gridjak1612/TDC-work_BTP/data/MANIFEST.md

# Capture manifest

Build parameters below were INFERRED from the data (code range, dead-zone
location), not recorded at capture time. From now on, record them when capturing.

| File | Build (inferred) | Codes (A) | Dead zone | Notes |
|---|---|---|---|---|
| sweep_full.csv | SYNC_TAP=0, TAP_SRC=0 | 1..288 | ph 268..275 (A), 268..275 (B) | Source of the 10.1 ps result and slide-2 even/odd. 185 seq gaps |
| probe.csv, probe2.csv | SYNC_TAP=0, TAP_SRC=0 | 1..288 | same as sweep_full | probe.csv -> lut_a/lut_b |
| sweep_v2.csv | SYNC_TAP=30, TAP_SRC=0 | 84..351 | ph 189..213 (A), 182..214 (B) | 474 seq gaps; 1 corrupt frame (phase = -859) |
| probe_ilv.csv, ilv_check.csv | SYNC_TAP=30, TAP_SRC=0 on both chains (NOT interleaved) | 84..351 | as sweep_v2 | Identical to sweep_v2 at 279/280 phases. Source of slide 4/7 DNL/INL |
| probe3.csv, live.csv | SYNC_TAP=30 | 84..351 | - | live.csv has host-computed interval_ps |
| tdc_dual_log.csv, tdc_log.csv | pre-DPS builds | - | - | historical |
| lut_full_*.csv | from sweep_full | | | |
| lut_v2_*.csv | from sweep_v2 | | | |

## Rule from here on
Name every capture `<date>_<githash>_<desc>.csv`, e.g. `0925_a1b2c3d_sweep_sync30.csv`,
and add one line here: build params, bitstream hash, temperature if known.
A LUT is only valid for the bitstream (placement) it was built from.
| 0924b_f62460d_ro7_sync30.csv | EVENT_SRC=3, RO_STAGES=7, f62460d, 5-min warm-up | 2.97 M frames |
| 0924b_f62460d_dps_sync30.csv | EVENT_SRC=2 (DPS), f62460d, 5-min warm-up | 1.36 M frames, LED7 off throughout |
| 0924b_f62460d_ro11_sync30.csv | EVENT_SRC=3, RO_STAGES=11, f62460d, 5-min warm-up | 3.02 M frames |
| 0924c_e0f33e7_ro7_sync30_ds.csv | step 4 DUAL_SNAP=1, e0f33e7 | 3.17 M frames. Chain A dead zone 0. Chain B biased by the pairing bug (2.65 % timeouts): do NOT use lut_cd7_ds_b |
| 0924d_0dcbbe8_ro7_sync30_ds.csv | DUAL_SNAP=1 + either-order pairing, 0dcbbe8, 5-min warm-up | 3.26 M frames; dead zone 0 both chains; 0 timeouts; sigma_pair 14.65 ps. LUT: lut_cd7_final (valid for 0dcbbe8 only) |
| 0924e_0dcbbe8_ro7_sync30_ds.csv | 0dcbbe8, independent eval run for calib_report | 2.16 M frames; residual DNL rms 0.02 LSB, residual INL <= 7 ps, sigma 10.34 ps/ch |
| 0925_multi_ro7.csv + 0925_multi_dps.csv | multi-source bitstream (EVENT_SRC=4), SW2 only (SW1 faulty) | RO7 2.99M, DPS 1.40M, dead zone 0 in both. Same-bitstream CD vs DPS: scale 0.5 %, shape +/-25 ps, CD LUT on DPS data 14.2-14.9 ps vs 11.2-12.1 ps |
| 0925_m3_ro7.csv + 0925_m3_ro11.csv | multi-source build, source select on SW2+SW3 (T2) | RO7 vs RO11 same bitstream: corr 1.000, 0.30 ps/bin, 0.00 % scale, +/-4 ps shape -> RO hit uniformity validated |
