gridjak1612/TDC-work_BTP/code/ilv_report.txt

loaded 1433607 rows from probe_ilv.csv
sequence gaps (dropped measurements): 0
up-traversal rows: 719367   down-traversal rows: 714240
phase step 17.857 ps, 280 steps, period 5000.0 ps

==========================================================================
  CHAIN A
==========================================================================
  usable samples : 1306594
  railing phases : 24 steps = 429 ps dead zone
      phases 189..212  (429 ps)
      This is the launch-skew ambiguity: events landing inside the
      capture synchroniser's setup window resolve either way, so the
      snapshot is taken one clock late and the chain reads full.

  --- transfer curve (mean code vs phase) ---
      phases with data : 256 / 280
      code range       : 84.0 .. 351.0
      median slope     : -0.990 codes / step   -> tau = 18.03 ps/tap
      steps against the dominant direction : 0 / 254  (0.0 %)

  --- code density (aggregate histogram) ---
      reachable codes  : 84 .. 351  (268 codes)
      headroom unused  : 1 taps above the reachable range
      zero-width bins  : 16 / 268 (6.0 % WITHIN the reachable range)
      phase coverage : 256/280 steps = 4571 ps
      LSB (covered/268) : 17.06 ps
      widest bin     : 77.2 ps (code 344)
      narrowest bin  : 0.00 ps (code 169)
      NOTE bin widths here are jitter-broadened; use the transfer
      curve for the transfer function and these for DNL shape only.
      DNL : -1.00 / +3.53 LSB
      INL : -3.94 / +7.79 LSB (-67 / +133 ps)
      widest bins (code: ps, xLSB):
         344:77(4.5x)  180:77(4.5x)  196:59(3.5x)  112:57(3.3x)  248:55(3.2x)  132:54(3.1x)  84:54(3.1x)  172:54(3.1x)  92:52(3.0x)  120:52(3.0x)
      even bins :  29.29 ps (n=134)   odd bins :   4.82 ps (n=134)
      EVEN/ODD ratio : 6.08x    85.9 % of the period is in even bins
         code %% 4 == 0 :  29.77 ps
         code %% 4 == 1 :   5.14 ps
         code %% 4 == 2 :  28.82 ps
         code %% 4 == 3 :   4.50 ps
      RMS quantisation, actual bins  : 10.43 ps
      RMS quantisation, if uniform   : 5.24 ps   <- headroom from tap interleaving
      clock-region boundary bins (predicted at taps (80, 280)):

  --- up vs down traversal (MMCM DPS hysteresis) ---
      phases compared : 254
      mean(up - down) : -0.002 codes = +0.0 ps
      worst |up-down| : 0.09 codes

==========================================================================
  CHAIN B
==========================================================================
  usable samples : 1261507
  railing phases : 33 steps = 589 ps dead zone
      phases 182..214  (589 ps)
      This is the launch-skew ambiguity: events landing inside the
      capture synchroniser's setup window resolve either way, so the
      snapshot is taken one clock late and the chain reads full.

  --- transfer curve (mean code vs phase) ---
      phases with data : 249 / 280
      code range       : 90.0 .. 351.0
      median slope     : -0.996 codes / step   -> tau = 17.94 ps/tap
      steps against the dominant direction : 0 / 247  (0.0 %)

  --- code density (aggregate histogram) ---
      reachable codes  : 90 .. 351  (262 codes)
      headroom unused  : 1 taps above the reachable range
      zero-width bins  : 14 / 262 (5.3 % WITHIN the reachable range)
      phase coverage : 249/280 steps = 4446 ps
      LSB (covered/262) : 16.97 ps
      widest bin     : 64.0 ps (code 184)
      narrowest bin  : 0.01 ps (code 185)
      NOTE bin widths here are jitter-broadened; use the transfer
      curve for the transfer function and these for DNL shape only.
      DNL : -1.00 / +2.77 LSB
      INL : -2.22 / +9.17 LSB (-38 / +156 ps)
      widest bins (code: ps, xLSB):
         184:64(3.8x)  308:63(3.7x)  132:58(3.4x)  120:56(3.3x)  284:55(3.2x)  212:55(3.2x)  252:54(3.2x)  176:54(3.2x)  264:54(3.2x)  332:53(3.1x)
      even bins :  29.00 ps (n=131)   odd bins :   4.94 ps (n=131)
      EVEN/ODD ratio : 5.87x    85.5 % of the period is in even bins
         code %% 4 == 0 :  28.01 ps
         code %% 4 == 1 :   4.00 ps
         code %% 4 == 2 :  29.98 ps
         code %% 4 == 3 :   5.86 ps
      RMS quantisation, actual bins  : 10.41 ps
      RMS quantisation, if uniform   : 5.18 ps   <- headroom from tap interleaving
      clock-region boundary bins (predicted at taps (76, 276)):

  --- up vs down traversal (MMCM DPS hysteresis) ---
      phases compared : 247
      mean(up - down) : +0.001 codes = -0.0 ps
      worst |up-down| : 0.10 codes
