gridjak1612/TDC-work_BTP/figs_extra/F01_hits_per_code.png

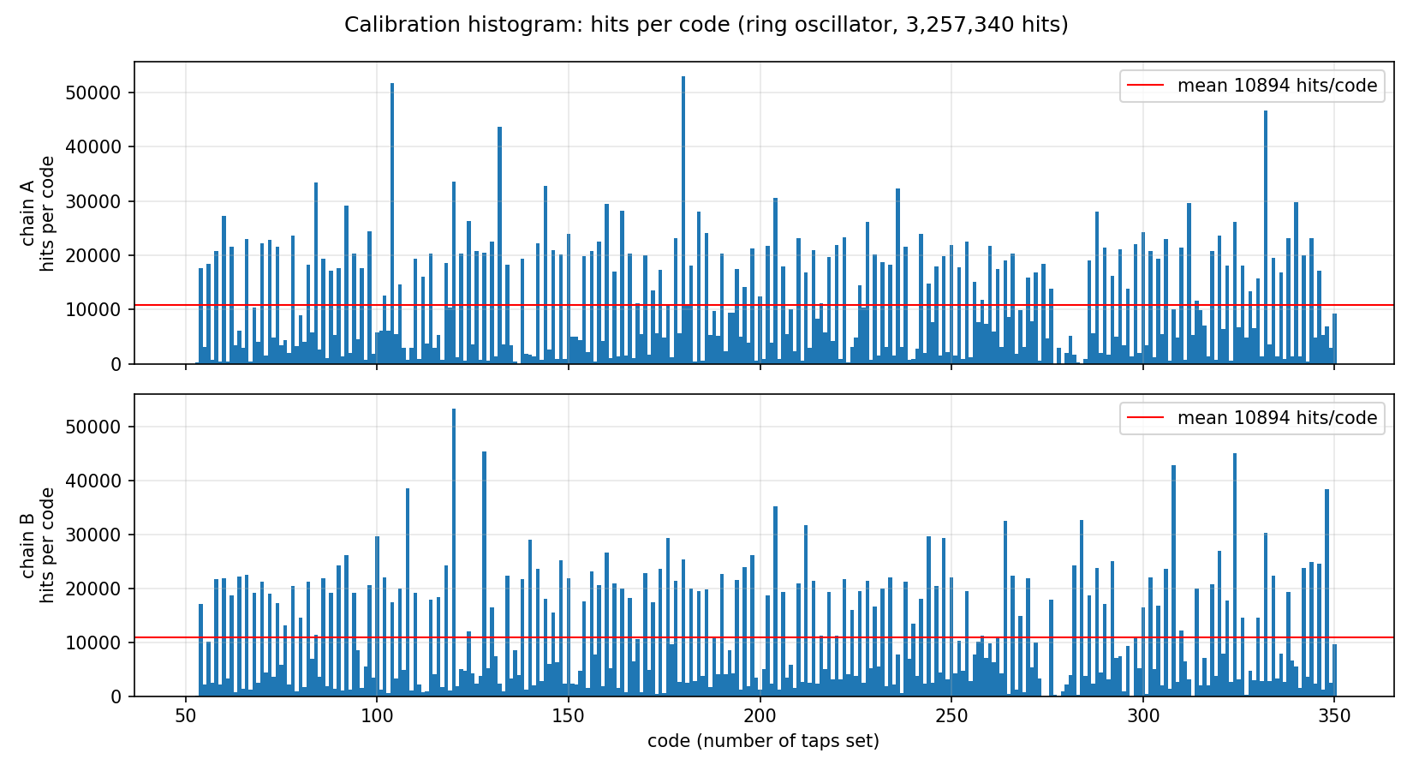
figs_extra/F01_hits_per_code.png
