gridjak1612/TDC-work_BTP/figs_extra/F02_binwidth_distribution.png

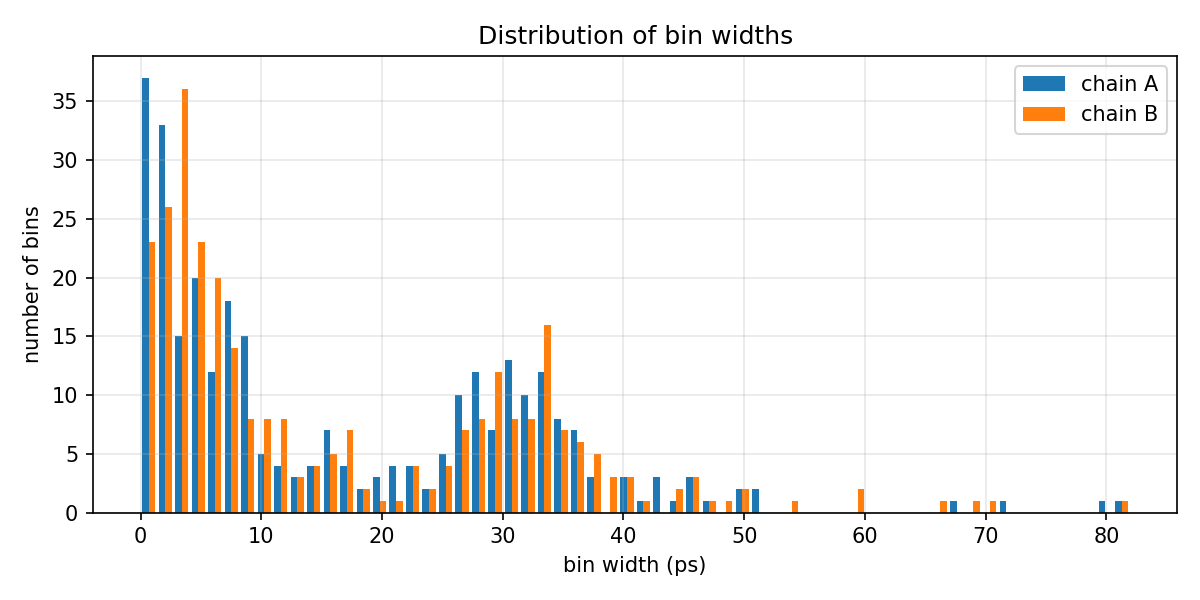
figs_extra/F02_binwidth_distribution.png
