gridjak1612/TDC-work_BTP/figs_extra/F03_width_by_carry4_position.png

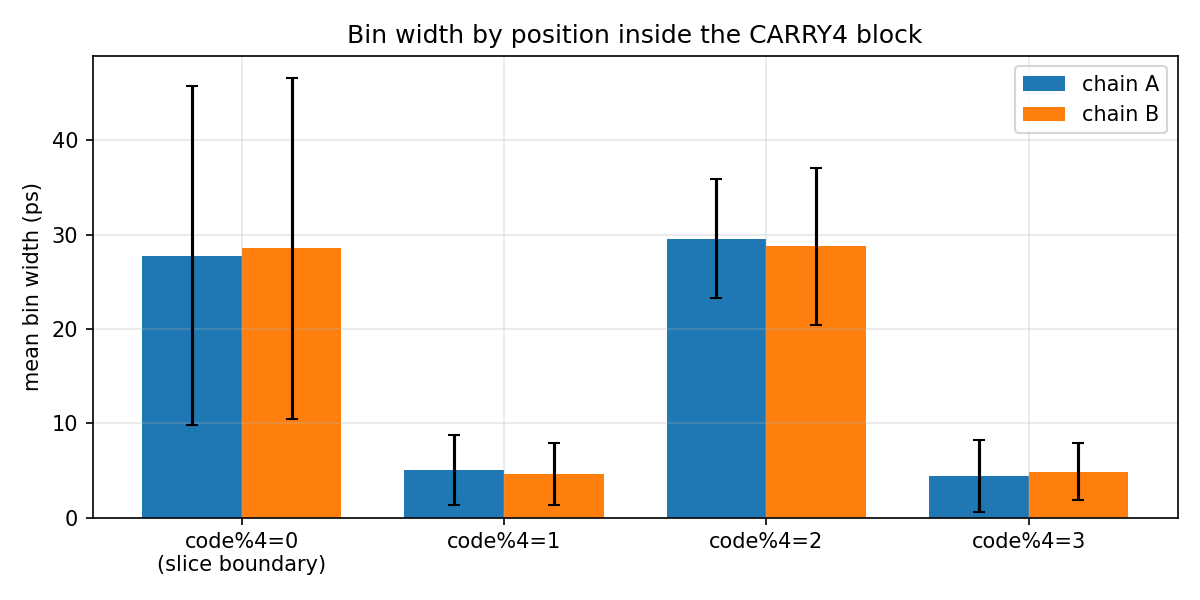
figs_extra/F03_width_by_carry4_position.png
