gridjak1612/TDC-work_BTP/figs_extra/F04_transfer_function_and_inl.png

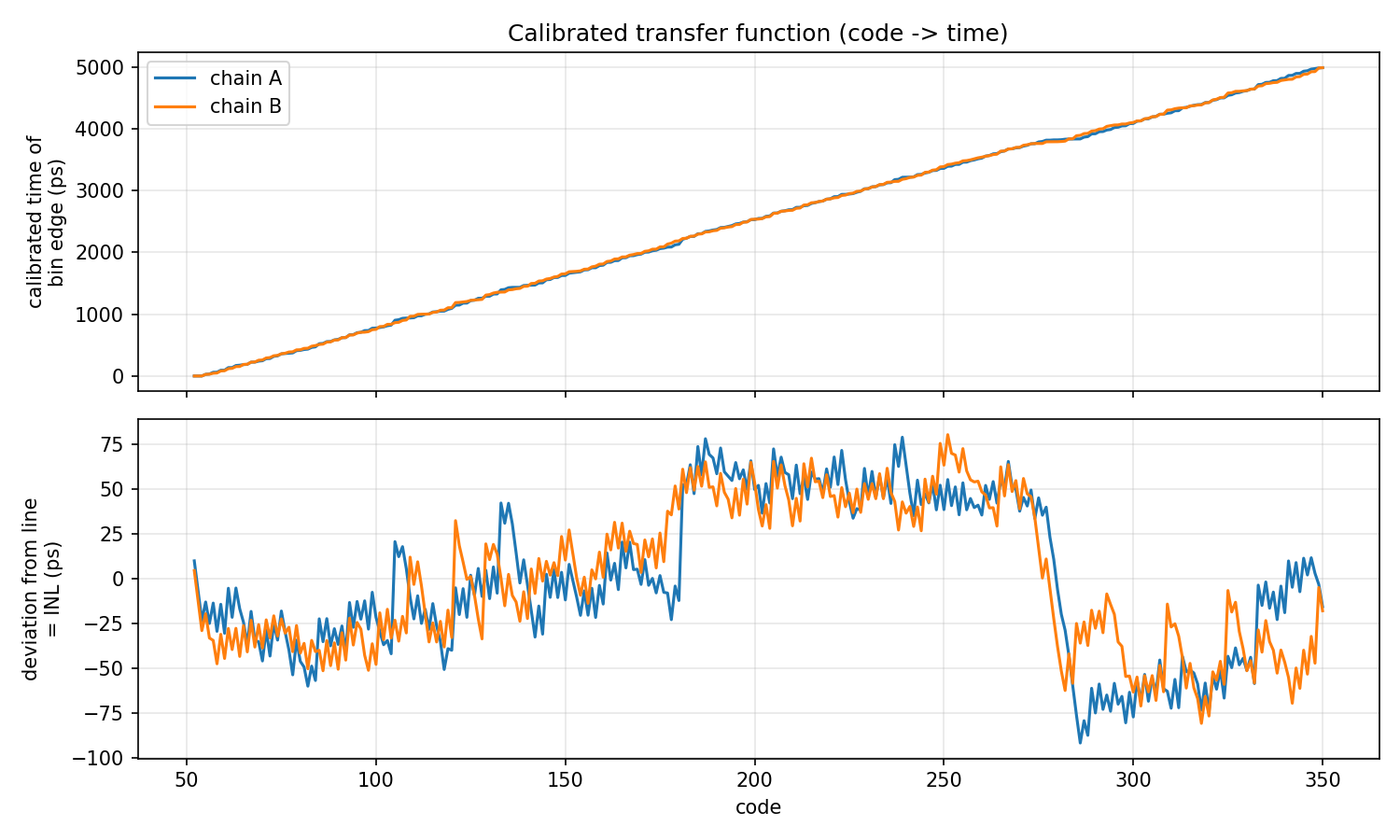
figs_extra/F04_transfer_function_and_inl.png
