gridjak1612/TDC-work_BTP/figs_extra/F05_repeatability.png

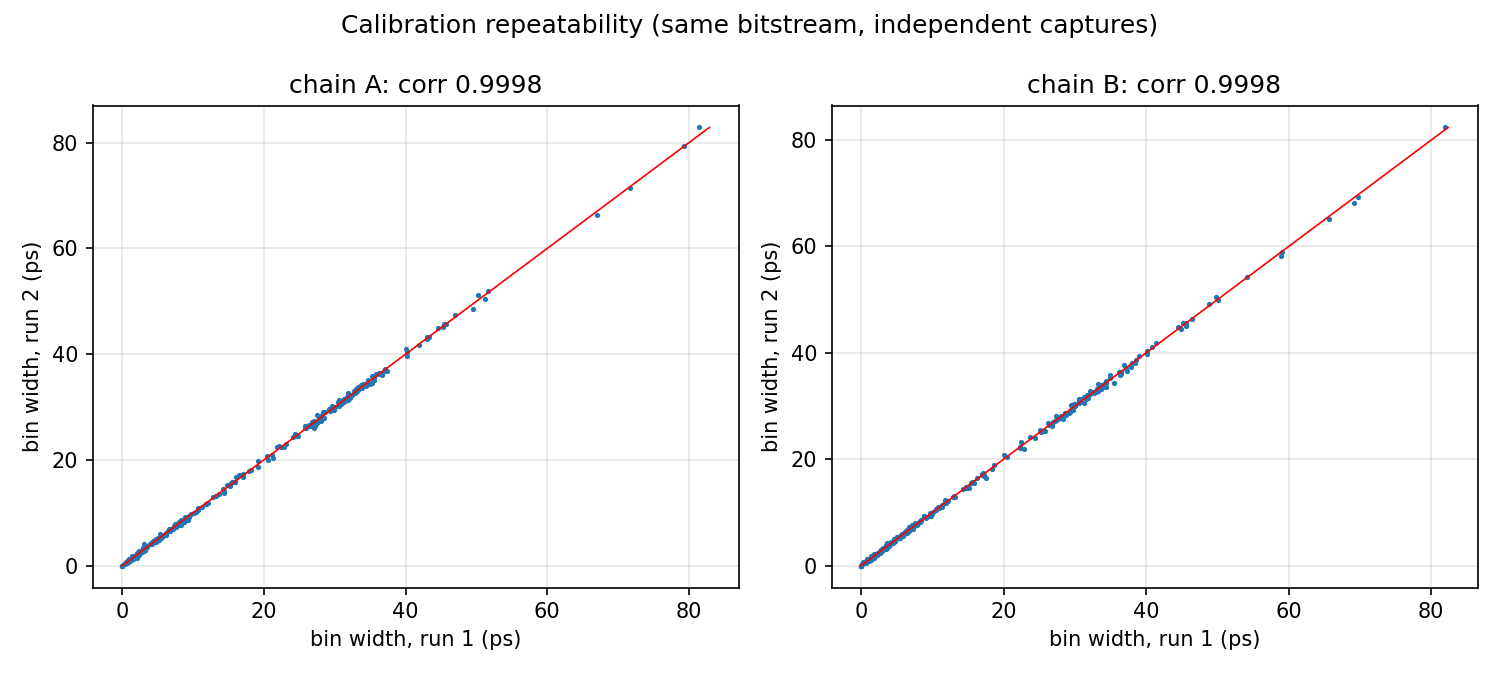
figs_extra/F05_repeatability.png
