gridjak1612/TDC-work_BTP/figs_extra/F06_chainA_vs_chainB.png

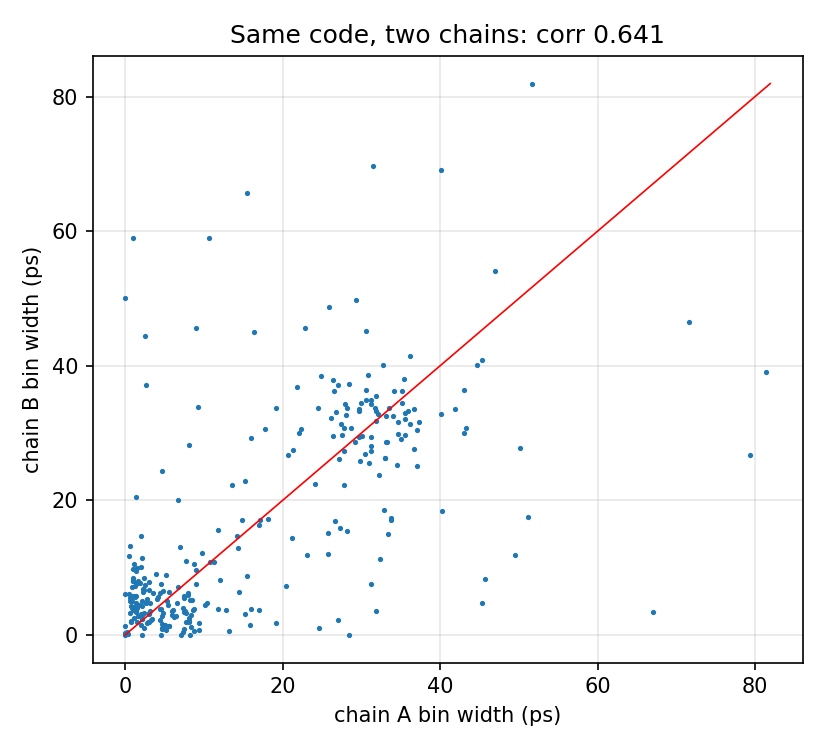
figs_extra/F06_chainA_vs_chainB.png
