gridjak1612/TDC-work_BTP/figs_extra/F07_bubbles_per_code.png

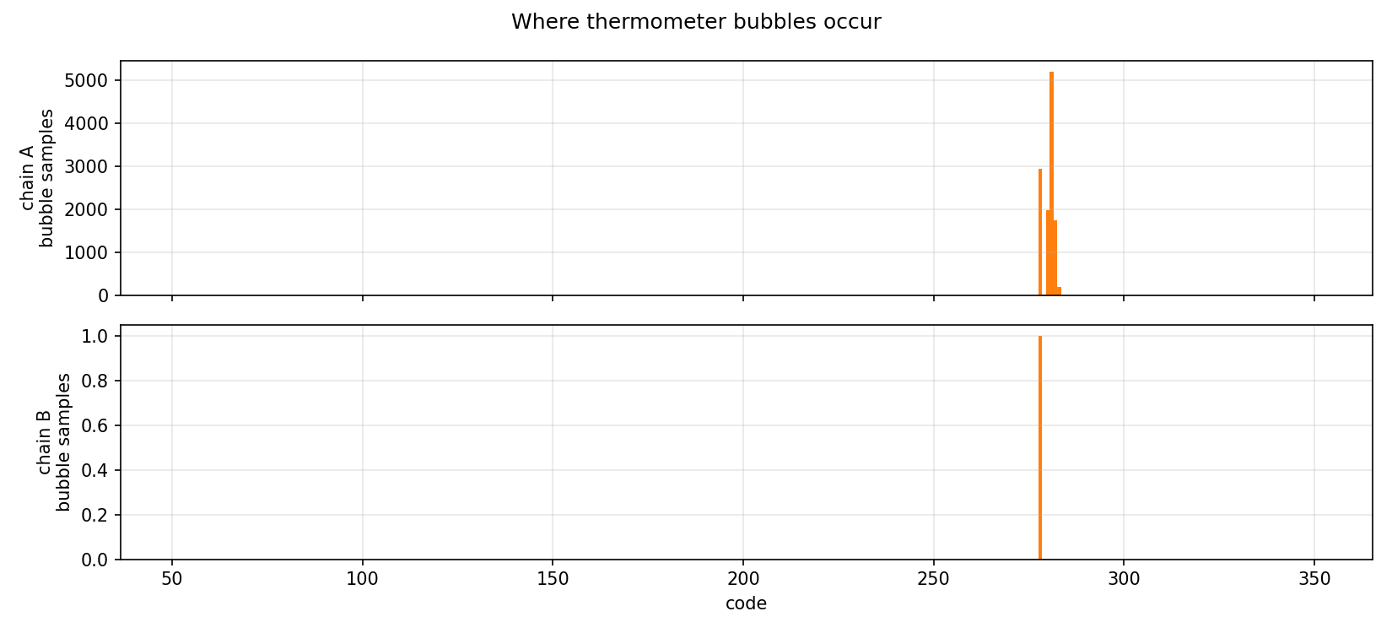
figs_extra/F07_bubbles_per_code.png
