gridjak1612/TDC-work_BTP/figs_extra/F08_codeA_vs_codeB.png

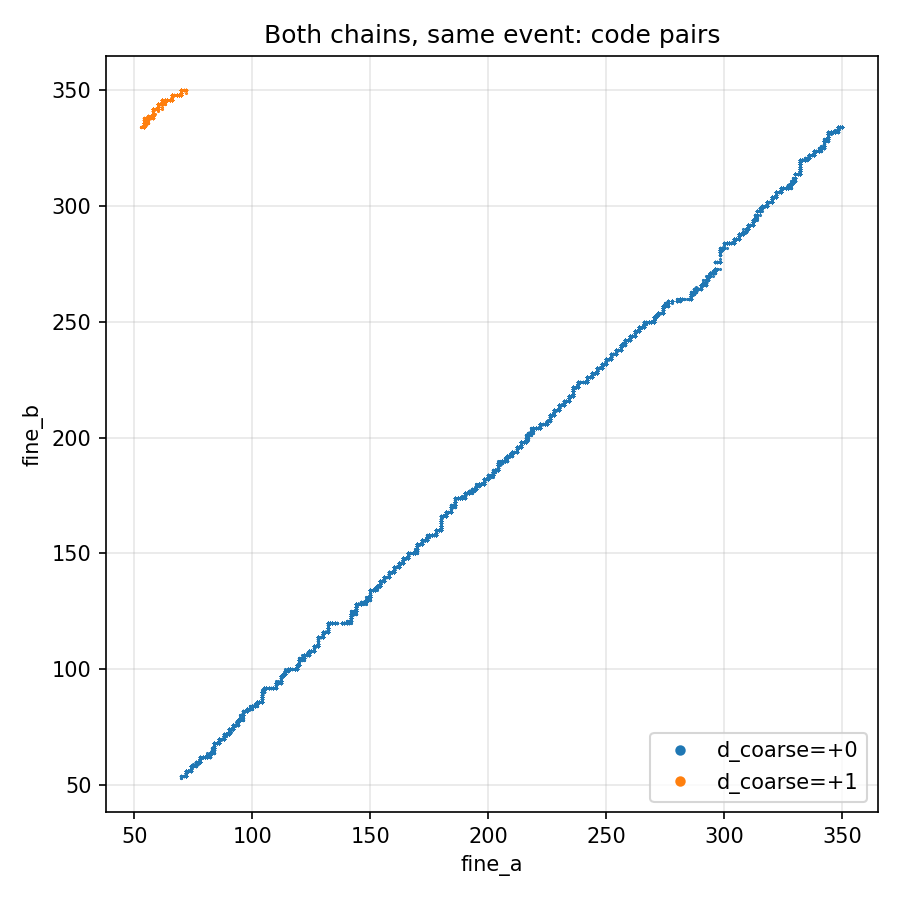
figs_extra/F08_codeA_vs_codeB.png
