gridjak1612/TDC-work_BTP/figs_extra/F09_precision_vs_code.png

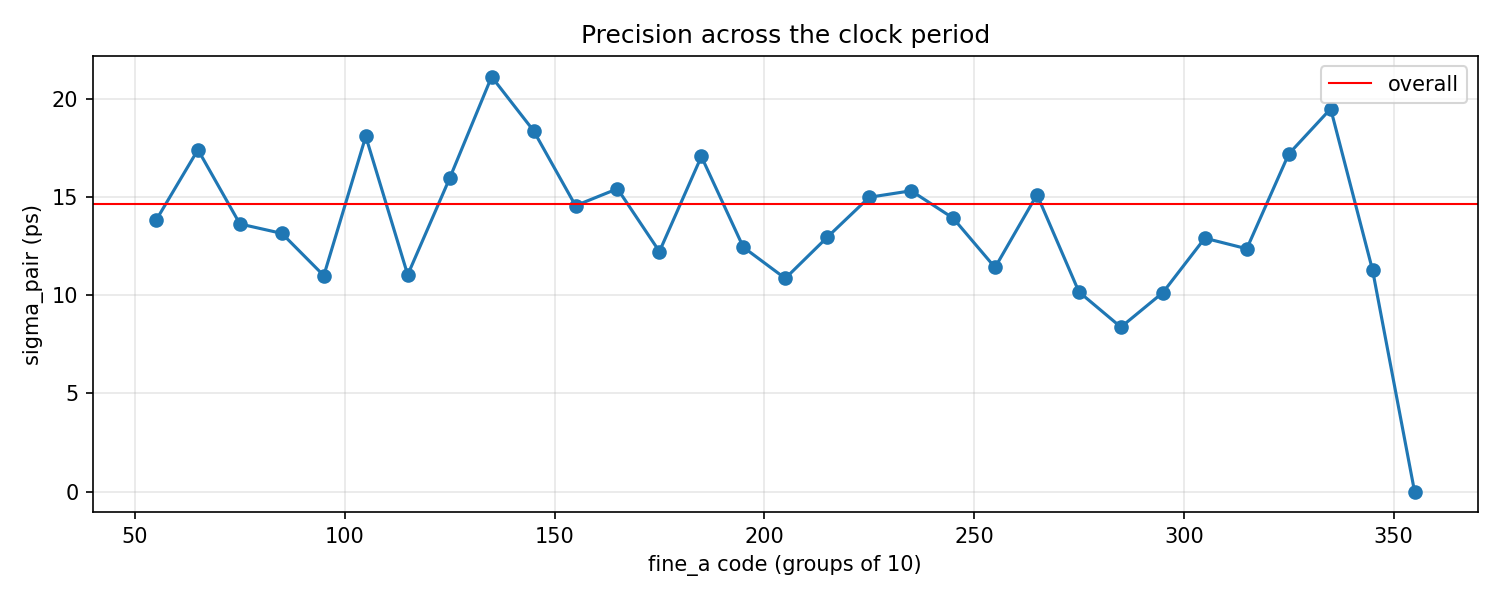
figs_extra/F09_precision_vs_code.png
