gridjak1612/TDC-work_BTP/figs_extra/F10_residual_by_dcoarse.png

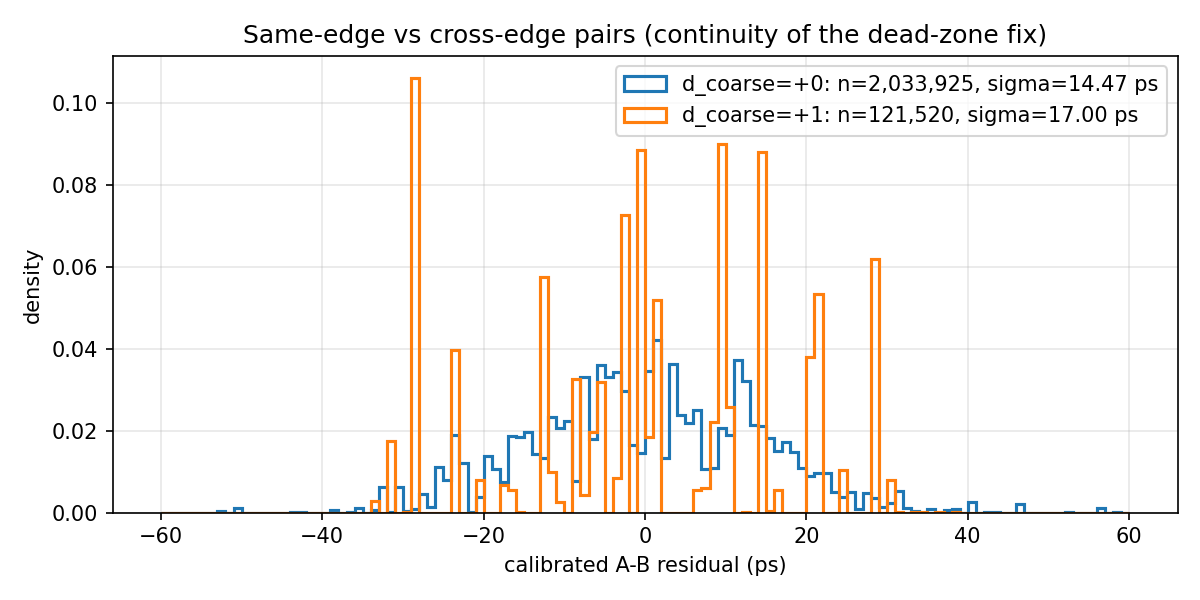
figs_extra/F10_residual_by_dcoarse.png
