gridjak1612/TDC-work_BTP/figs_extra/F11_quantisation_per_bin.png

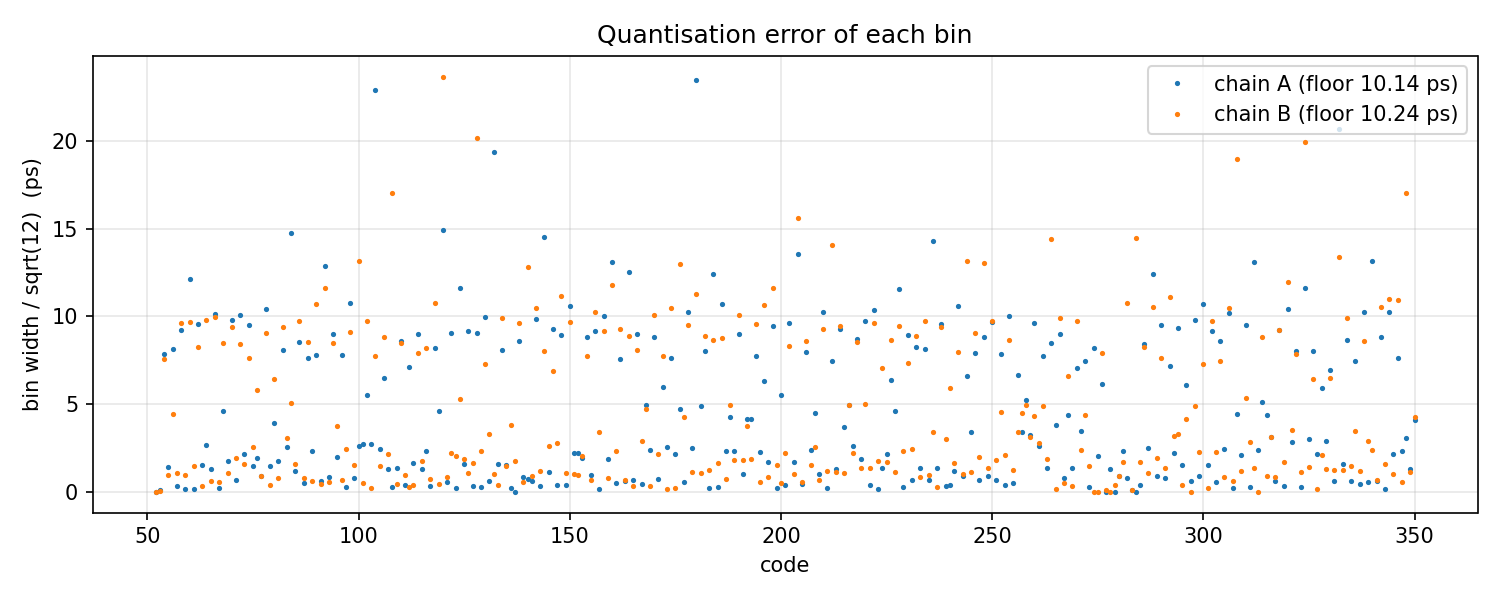
figs_extra/F11_quantisation_per_bin.png
