gridjak1612/TDC-work_BTP/figs_extra/F12_stability_over_time.png

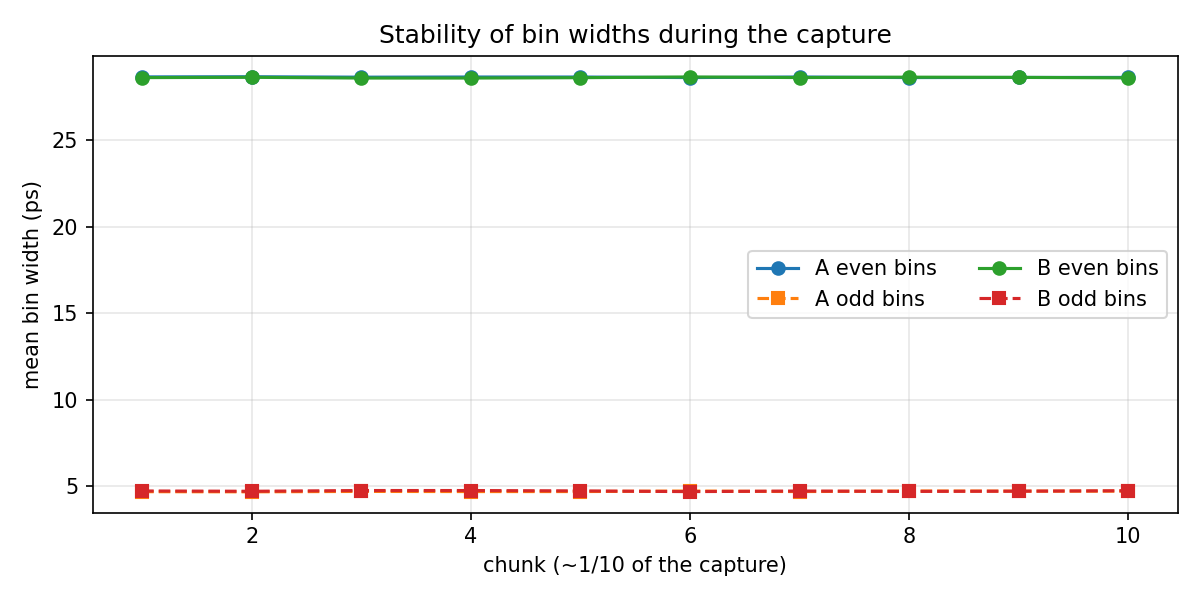
figs_extra/F12_stability_over_time.png
