gridjak1612/TDC-work_BTP/figs_extra/F13_dps_transfer_curve.png

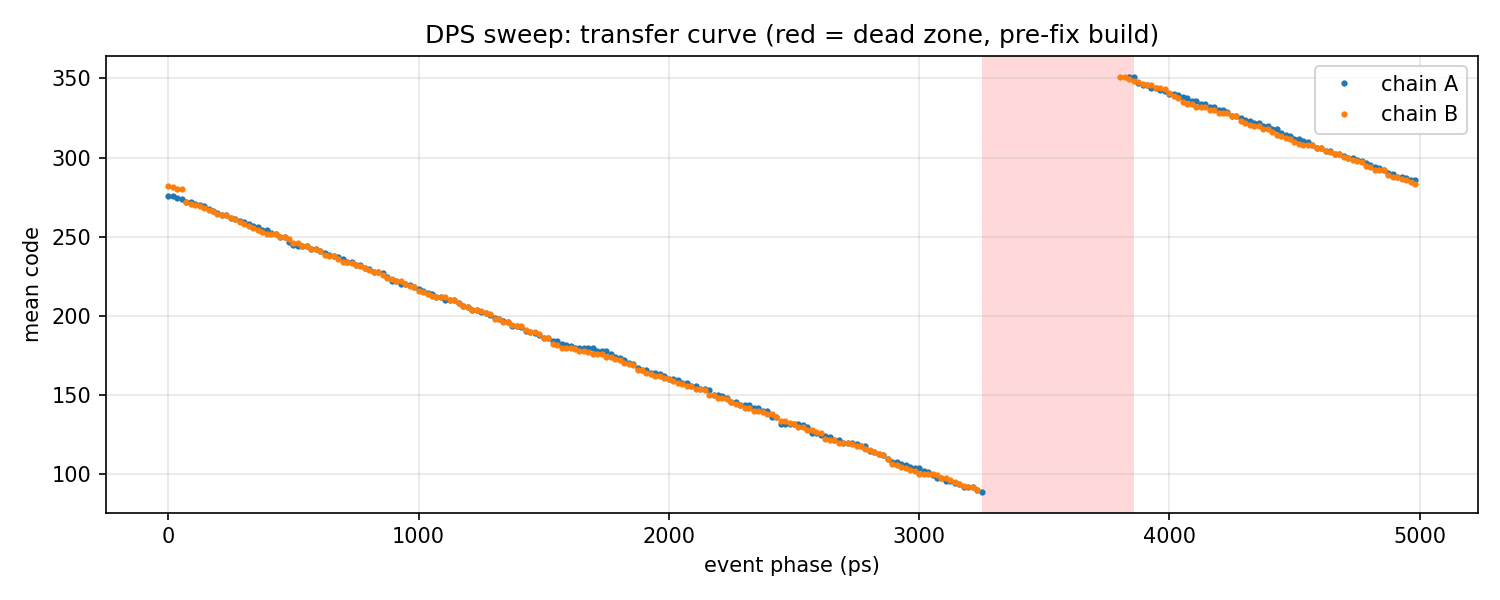
figs_extra/F13_dps_transfer_curve.png
