gridjak1612/TDC-work_BTP/figs_extra/F14_dps_hysteresis.png

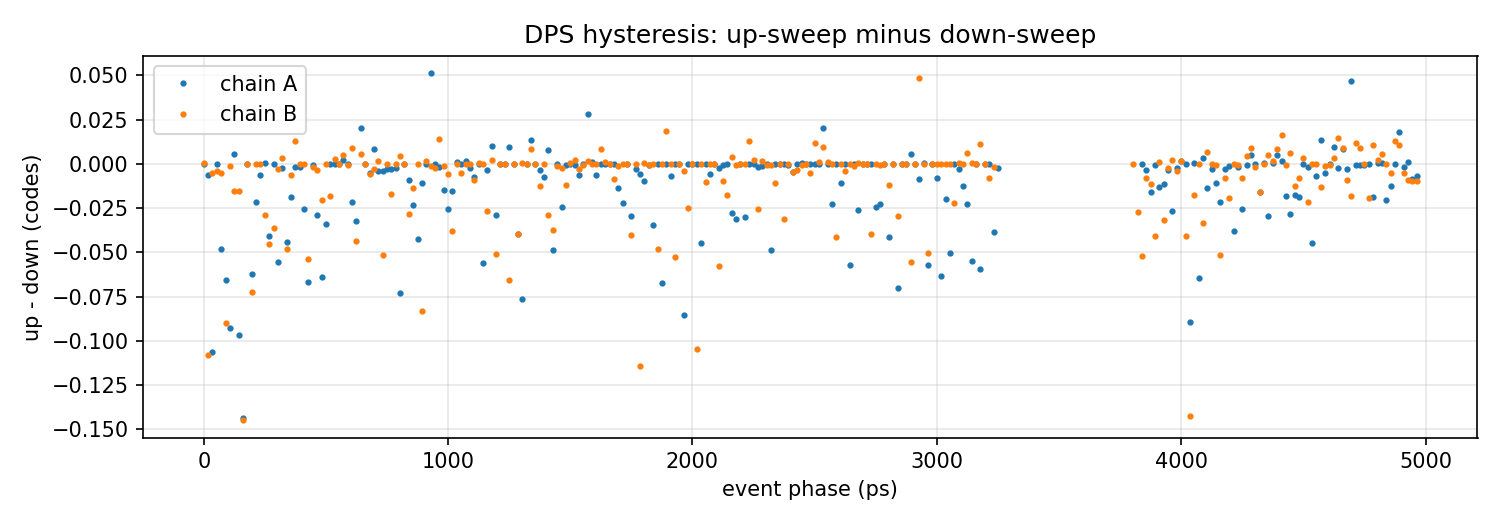
figs_extra/F14_dps_hysteresis.png
