gridjak1612/TDC-work_BTP/figs_extra/F15_dps_code_spread.png

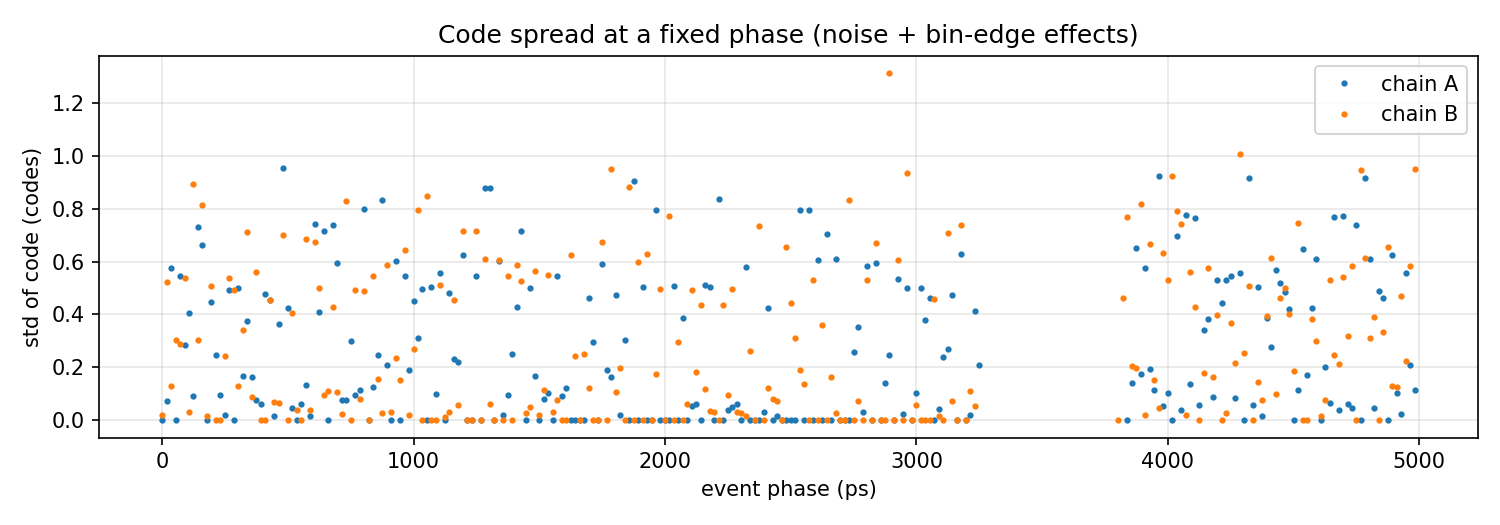
figs_extra/F15_dps_code_spread.png
