gridjak1612/TDC-work_BTP/figs_extra/F16_dead_zone_before_after.png

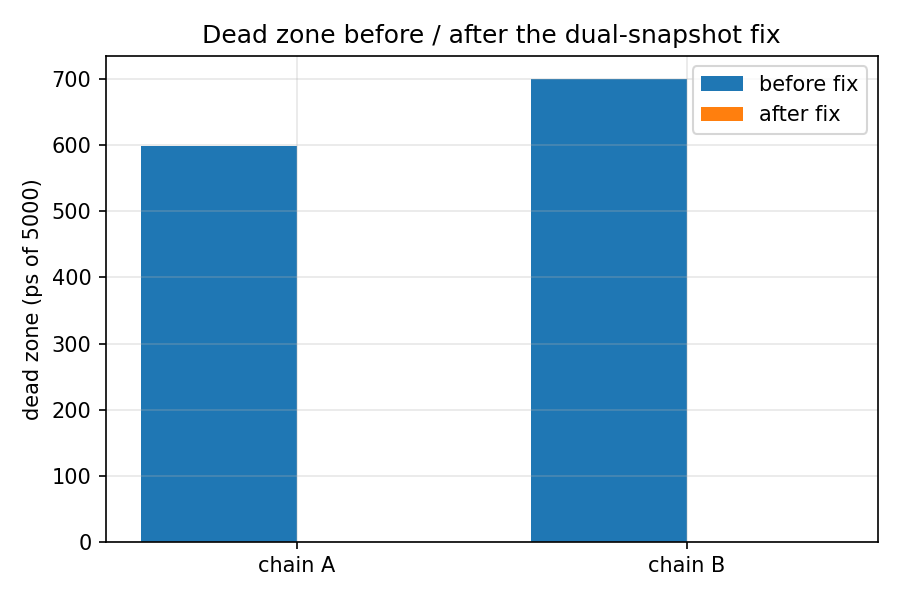
figs_extra/F16_dead_zone_before_after.png
