gridjak1612/TDC-work_BTP/figs_final/bin_widths.png

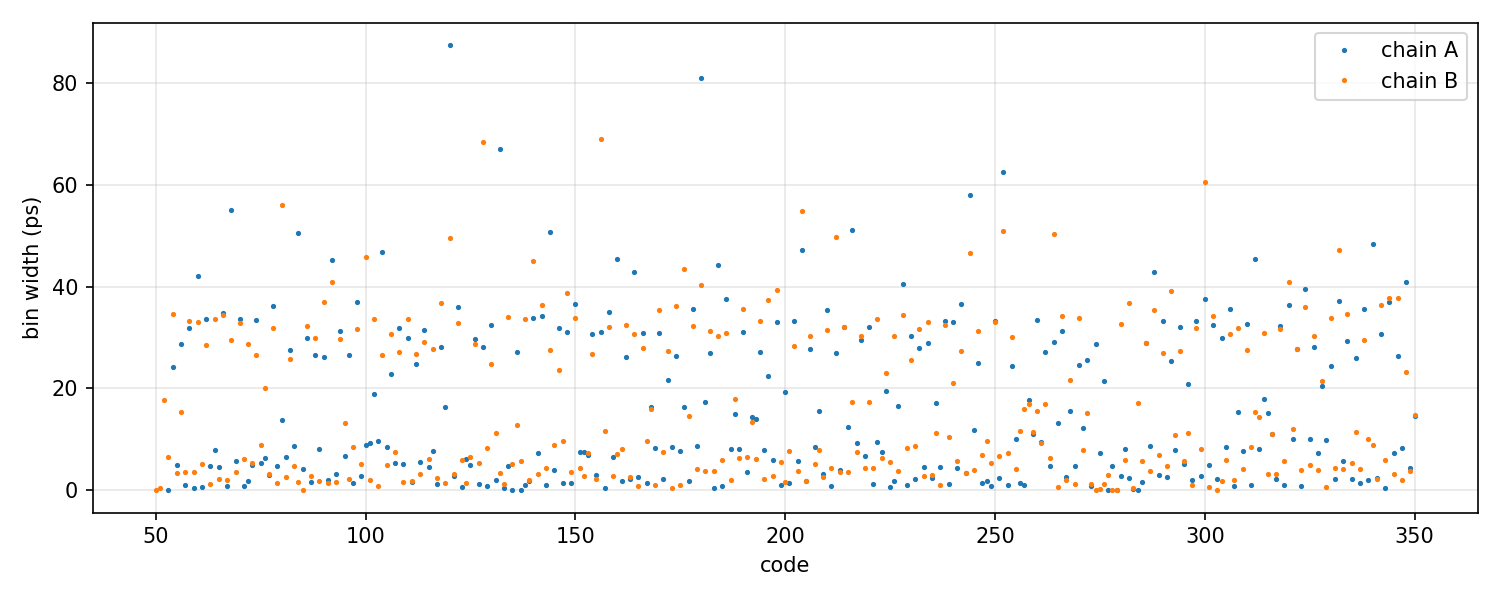
figs_final/bin_widths.png
