gridjak1612/TDC-work_BTP/figs_final/cal_dnl.png

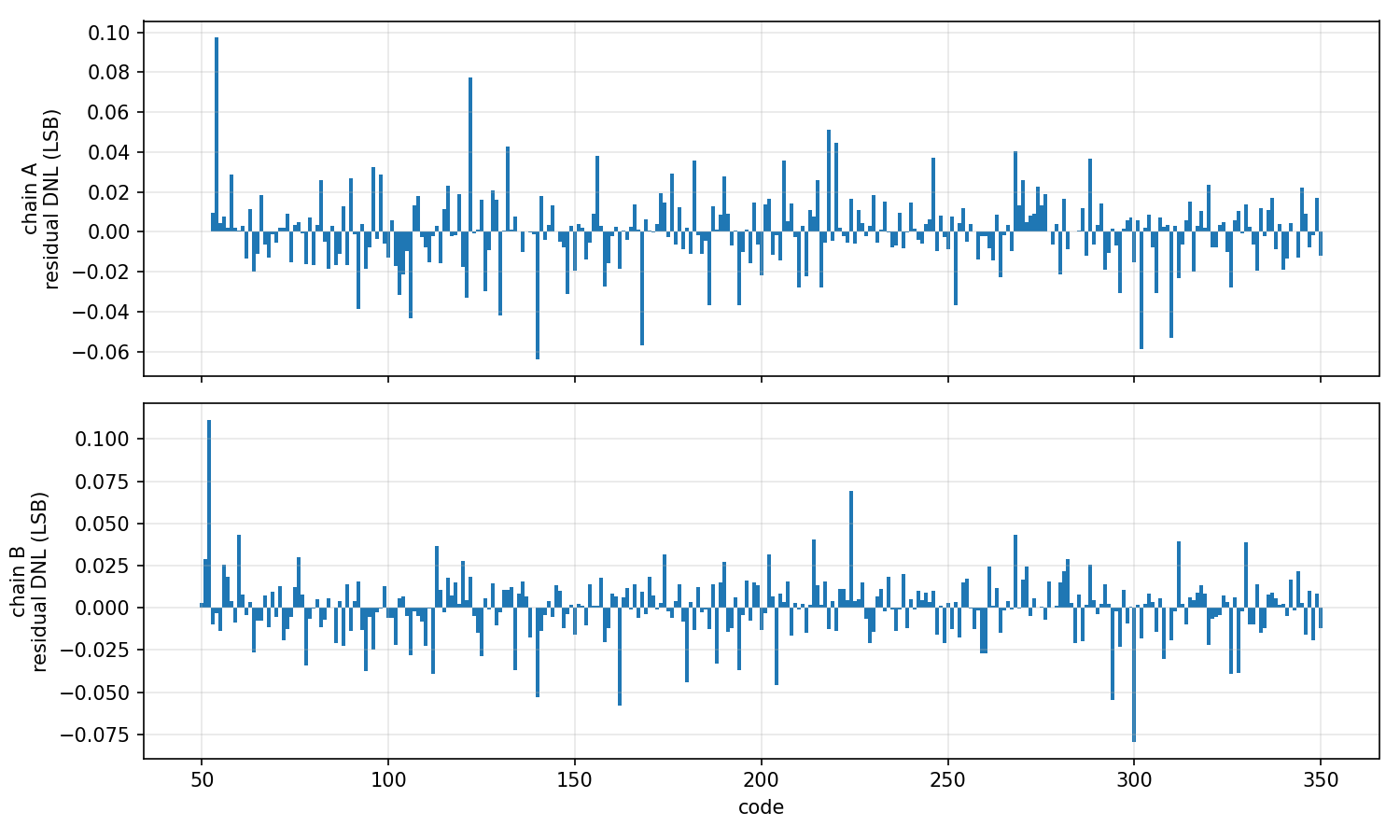
figs_final/cal_dnl.png
