gridjak1612/TDC-work_BTP/figs_final/cal_inl.png

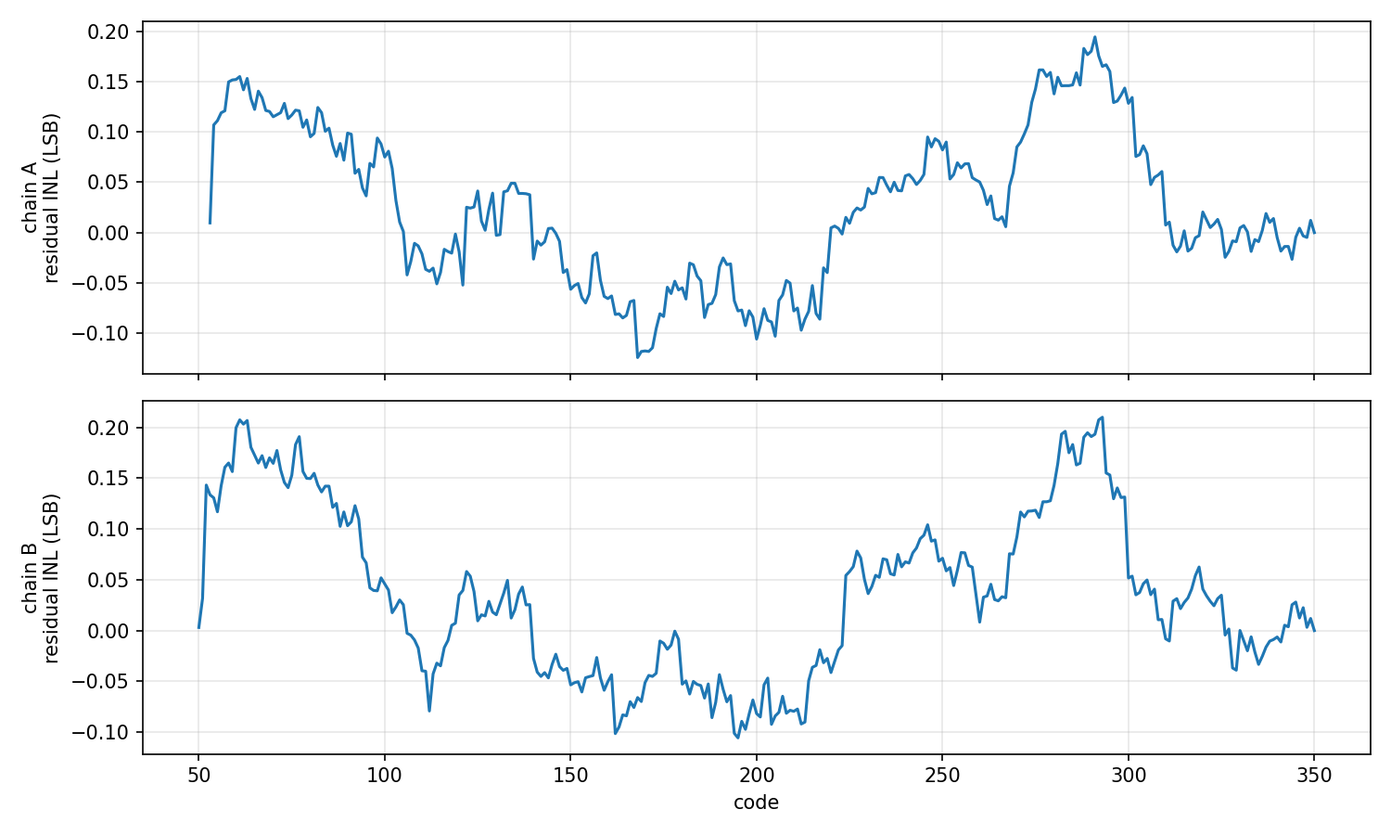
figs_final/cal_inl.png
