gridjak1612/TDC-work_BTP/figs_final/inl_before_after.png

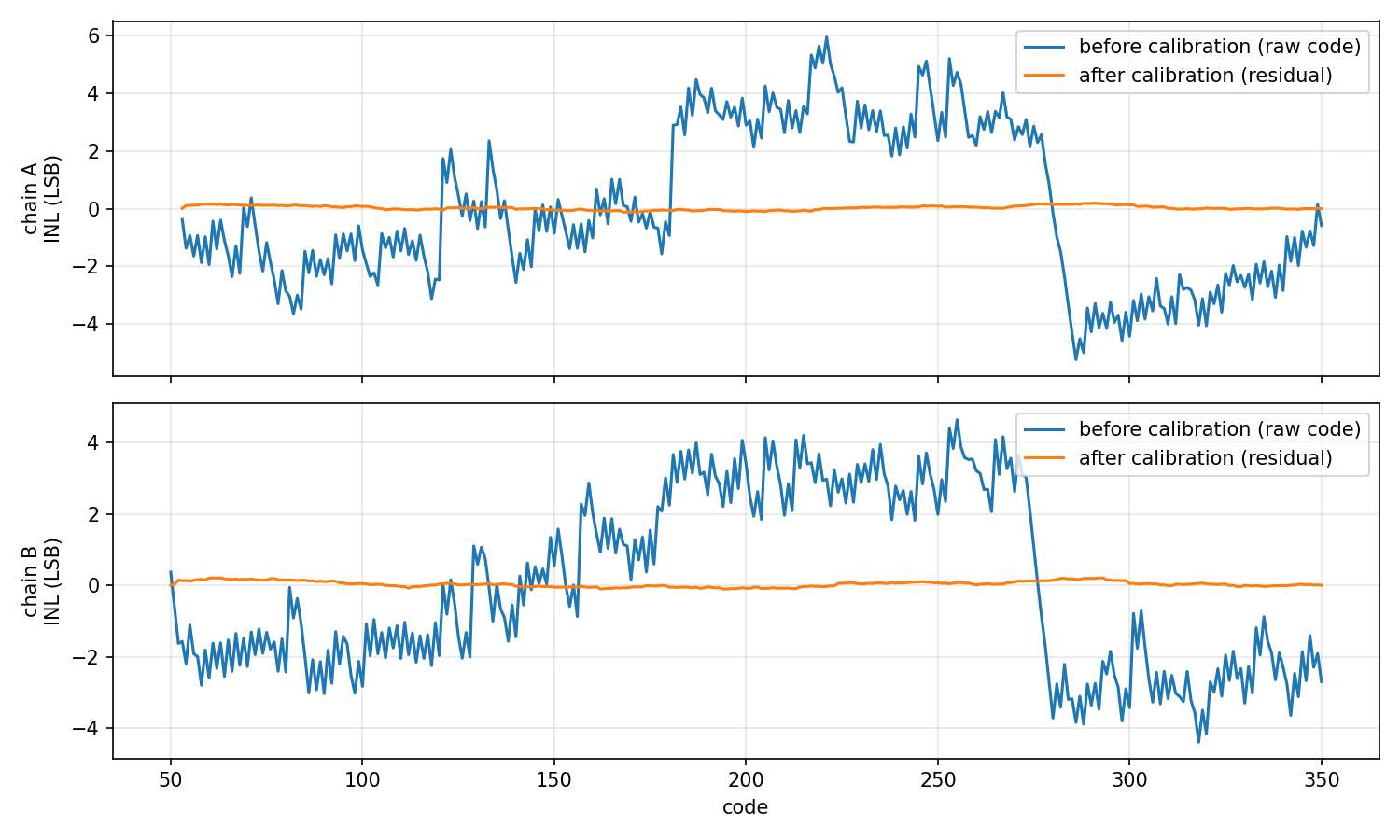
figs_final/inl_before_after.png
