gridjak1612/TDC-work_BTP/figs_final/precision_hist.png

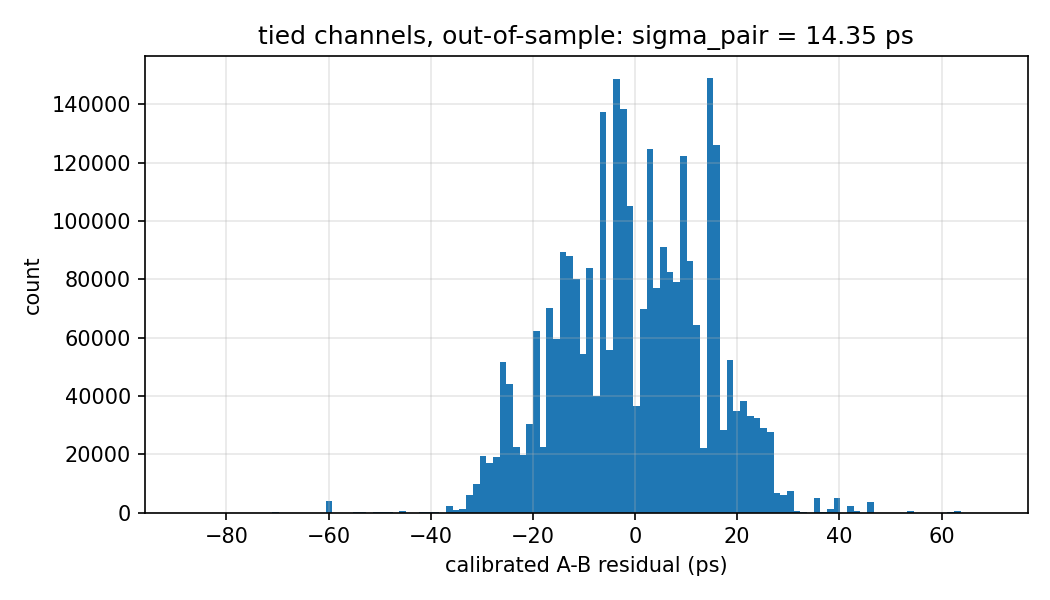
figs_final/precision_hist.png
