gridjak1612/TDC-work_BTP/figs_final/raw_dnl.png

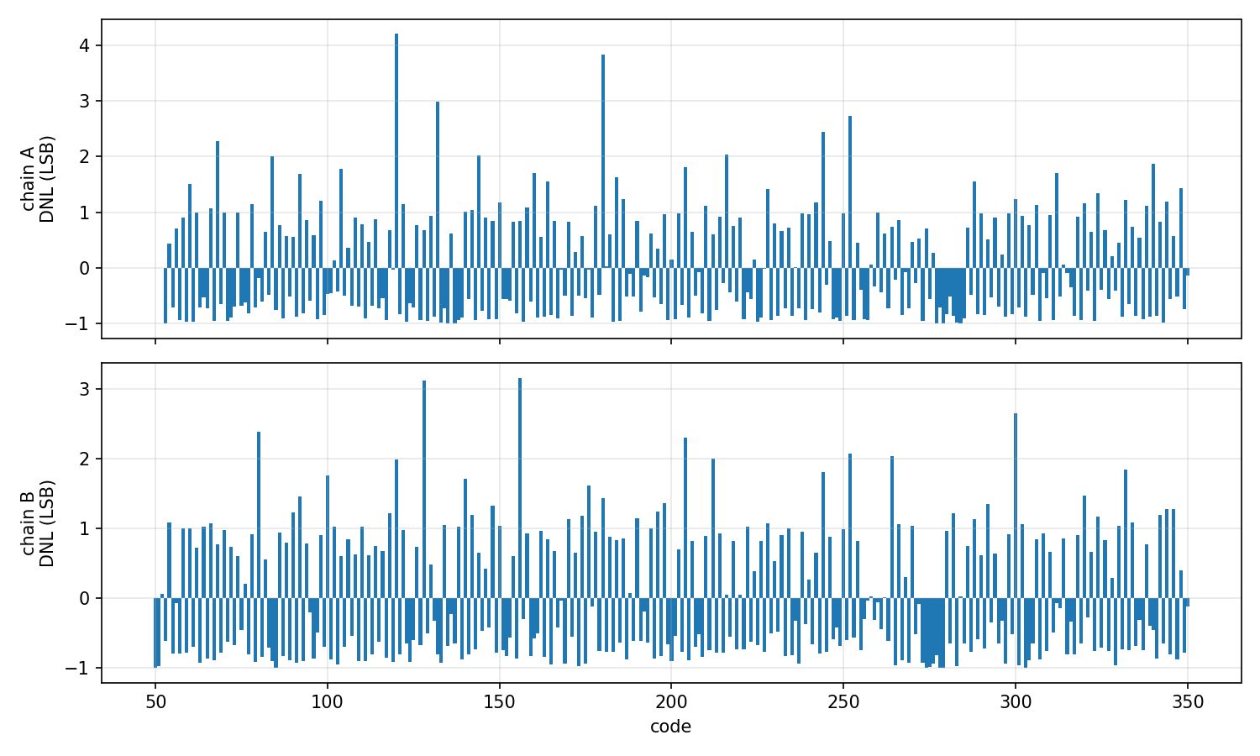
figs_final/raw_dnl.png
