gridjak1612/TDC-work_BTP/figs_final/raw_inl.png

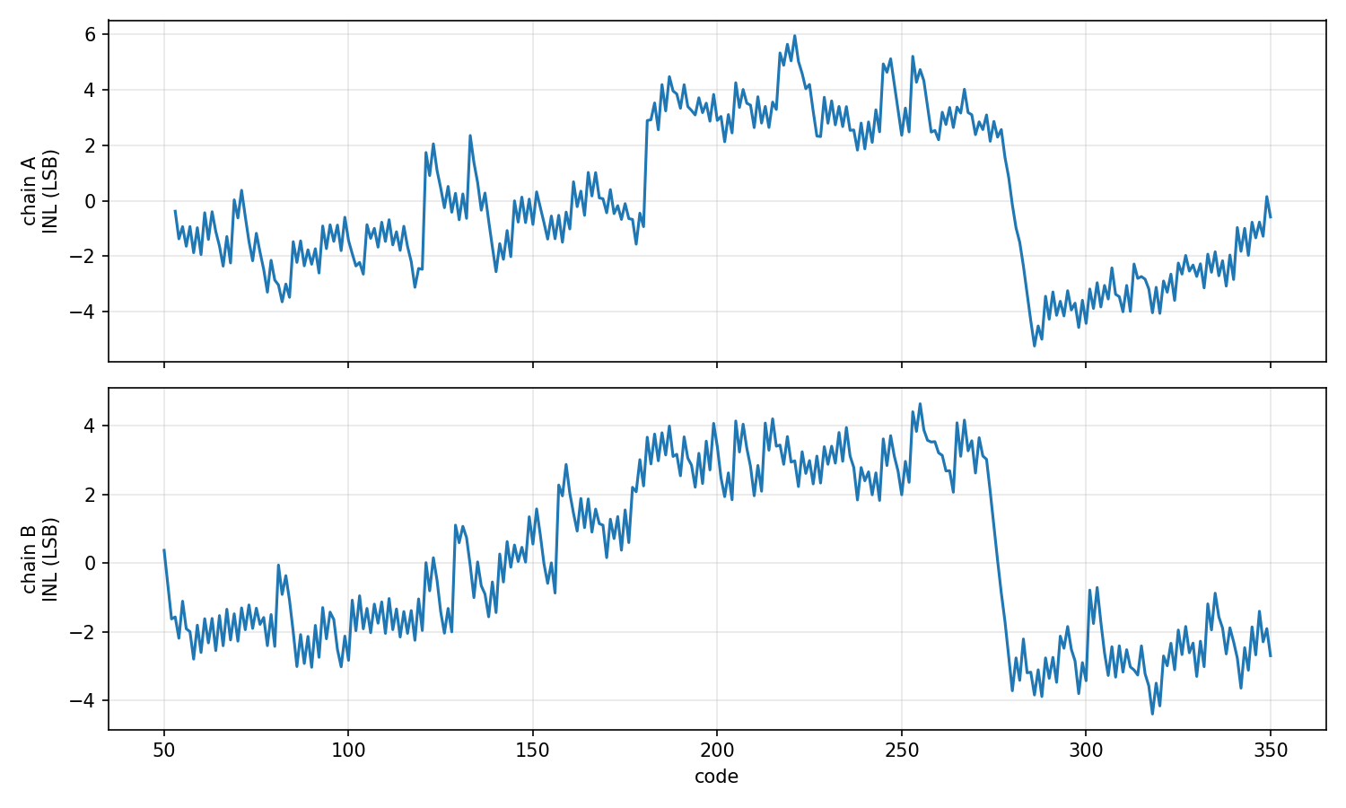
figs_final/raw_inl.png
