gridjak1612/TDC-work_BTP/figs_extra/F17_build_to_build_change.png

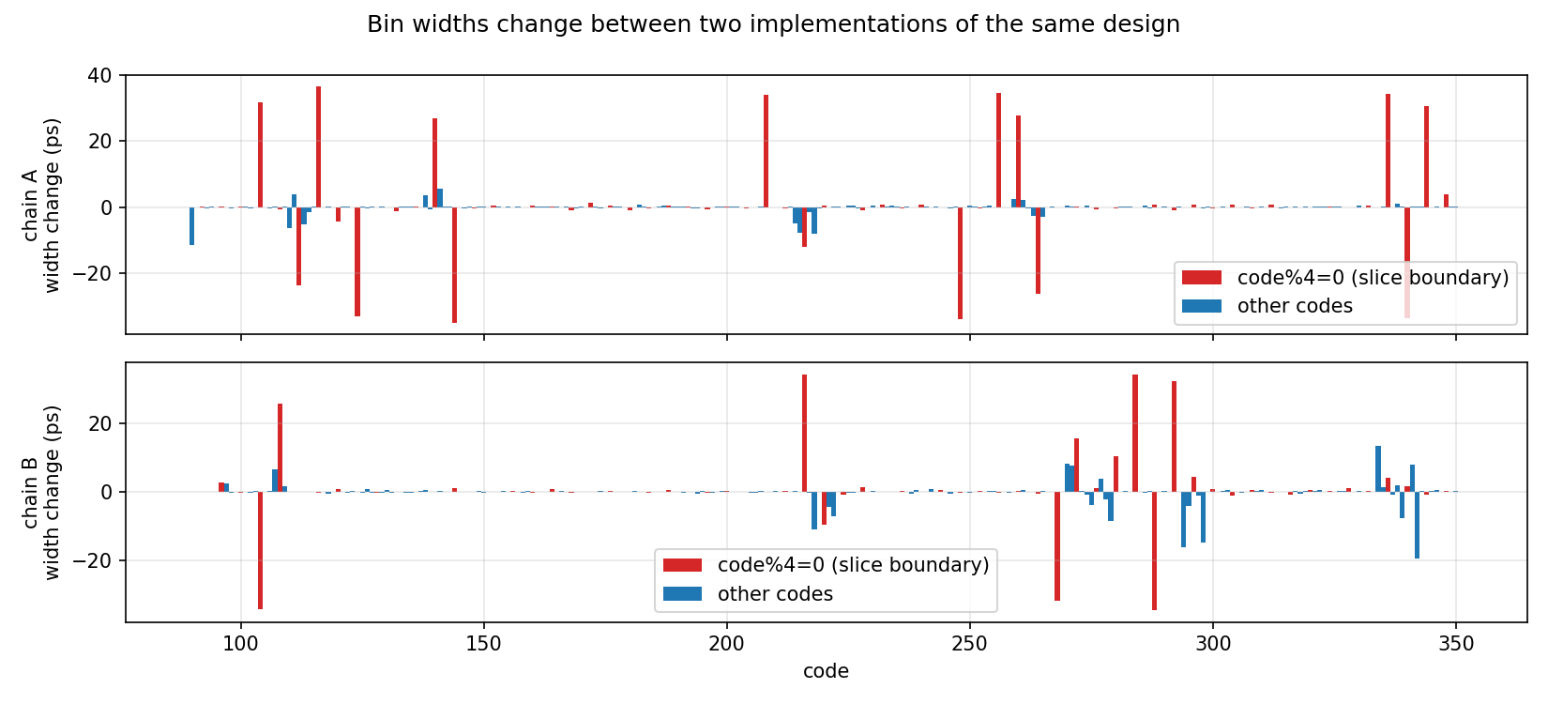
figs_extra/F17_build_to_build_change.png
