gridjak1612/TDC-work_BTP/(commit log)

2026-08-27 Day 1: Initial TDC project
    [tdc_dual_log.csv, tdc_log.csv]
2026-09-24 Snapshot: DPS calibration state (pre-fix), captures in data/raw
    [lut_a.csv, lut_b.csv, lut_full_a.csv, lut_full_b.csv, lut_v2_a.csv, lut_v2_b.csv, tdc_dual_log.csv, tdc_log.csv]
2026-09-24 Step 3: RO code-density source, CRC frame, re-arm deadlock fix (sim-verified in xsim)
    [apply_step3.py, check_uart_dump.py, code_density.py, read_tdc.py, ring_osc_event.v, tb_deadlock.v, tb_ro_cd.v]
2026-09-24 Step 4: dual-snapshot dead-zone fix (DUAL_SNAP), unit + regression sims pass
    [apply_step4.py, snapshot.v, tb_dual_snap.v, tdc_channel.v, tdc_dual_board.v, tdc_dual_top.v]
2026-09-24 Pair A/B in either order; host interval sign fix; |dc|>1 rejection; compare_luts; 0924 LUTs + manifest
    [lut_cd11b_a.csv, lut_cd11b_b.csv, lut_cd7_a.csv, lut_cd7_b.csv, lut_cd7_ds_a.csv, lut_cd7_ds_b.csv, lut_cd7b_a.csv, lut_cd7b_b.csv]
2026-09-24 Dead zone eliminated on both chains; 0 timeouts; sigma_pair 14.65 ps incl. cross-edge pairs (0dcbbe8)
    [lut_cd7_final_a.csv, lut_cd7_final_b.csv]
2026-09-24 calib_report: before/after DNL-INL + out-of-sample precision; figures for 0dcbbe8
2026-09-24 Foundation: frame v4 (11-bit fine, cfg byte), run-time source select EVENT_SRC=4, reset synchronizer, --rail-max
    [apply_step5.py, calib_report.py, check_uart_dump.py, code_density.py, constraint.xdc, extra_figs.py, read_tdc.py]
2026-09-24 Same-bitstream validation: RO code density vs DPS agree to 0.5 % scale, +/-25 ps shape
    [lut_multi_dps_a.csv, lut_multi_dps_b.csv, lut_multi_ro7_a.csv, lut_multi_ro7_b.csv]
2026-09-24 RO7 vs RO11 on same bitstream: identical bins (0.30 ps/bin) -> calibration method fully validated
    [lut_m3_ro11_a.csv, lut_m3_ro11_b.csv, lut_m3_ro7_a.csv, lut_m3_ro7_b.csv]
2026-09-24 Final calibration report; per-source A-B offset handled in figures
2026-09-28 return-path probe: rtl, tb, constraints, host (xsim + sim-check pass)
2026-09-28 move sources into code/; add m2 LUTs, extra figs
    [lut_m2_ro11_a.csv, lut_m2_ro11_b.csv, lut_m2_ro7_a.csv, lut_m2_ro7_b.csv]
